NQB26/VDK-Canh-tay-robot/3D PARTS/gripper_finger_l.STL

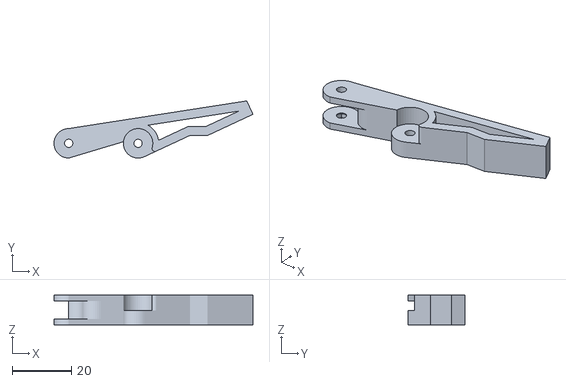
[picture p1: CAD file, 2026-10-27]
3D PARTS/gripper_finger_l.STL
67.4 x 19.4 x 10.0
