NQB26/VDK-Canh-tay-robot/3D PARTS/khop_xoay.STL

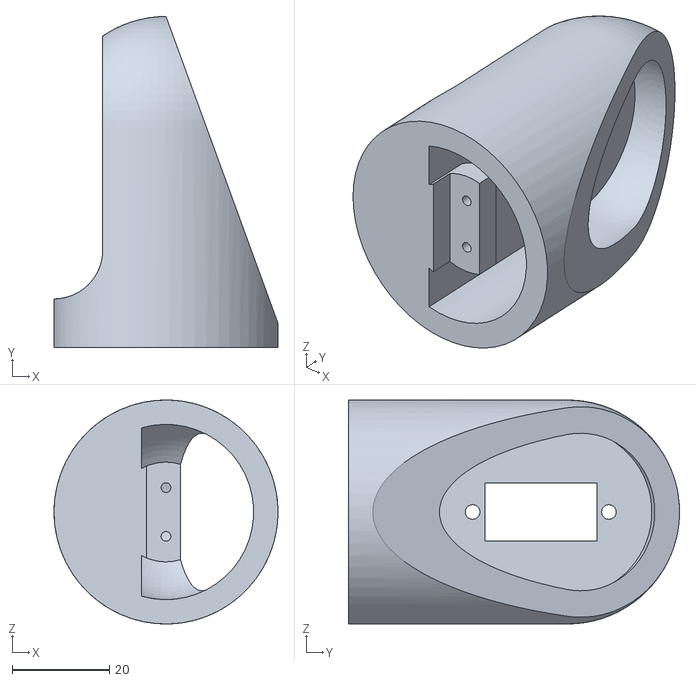
[picture p2: CAD file, 2026-10-27]
3D PARTS/khop_xoay.STL
46.0 x 68.0 x 46.0
