NQB26/VDK-Canh-tay-robot/3D PARTS/gripper_body_cover.STL

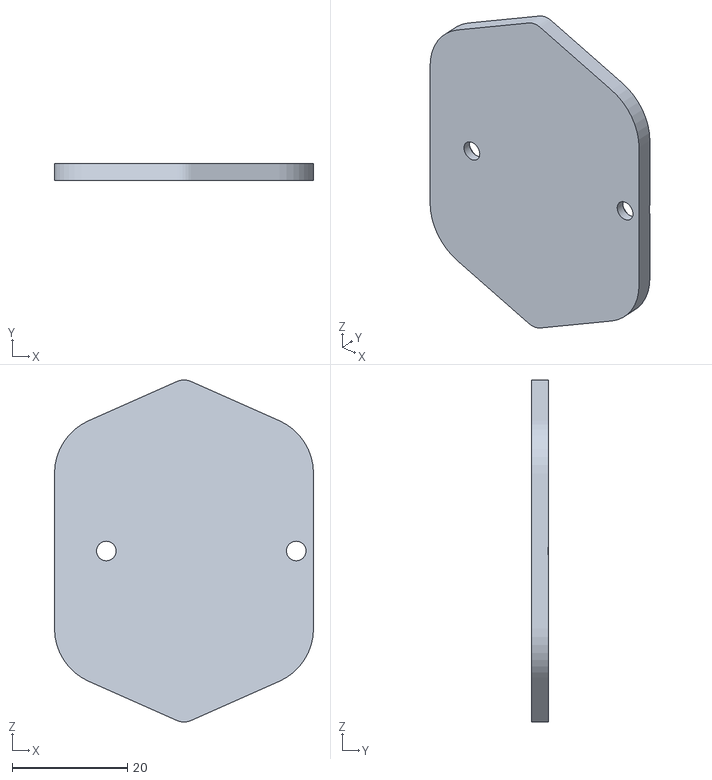
[picture p3: CAD file, 2026-10-27]
3D PARTS/gripper_body_cover.STL
45.0 x 3.00 x 59.4
