NQB26/VDK-Canh-tay-robot/3D PARTS/canh_tay_don_3.STL

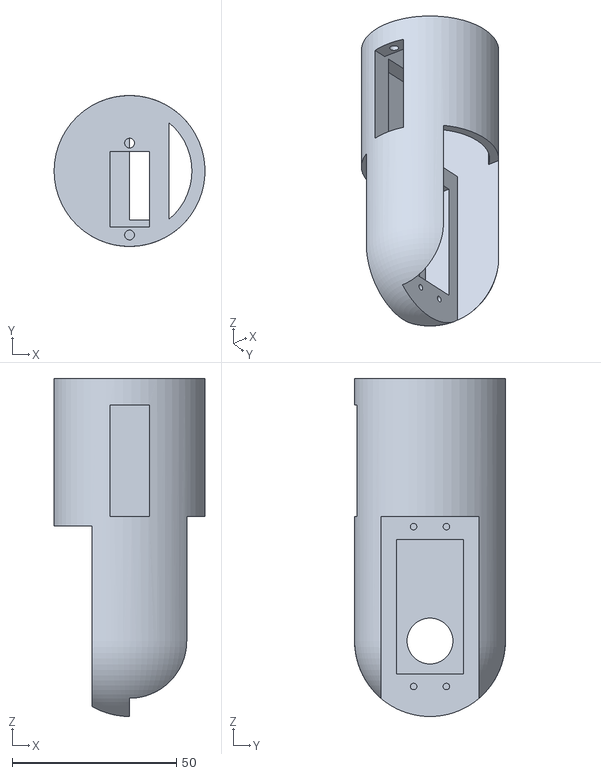
[picture p4: CAD file, 2026-10-27]
3D PARTS/canh_tay_don_3.STL
46.0 x 46.0 x 103.0
