NQB26/VDK-Canh-tay-robot/3D PARTS/gripper_link.STL

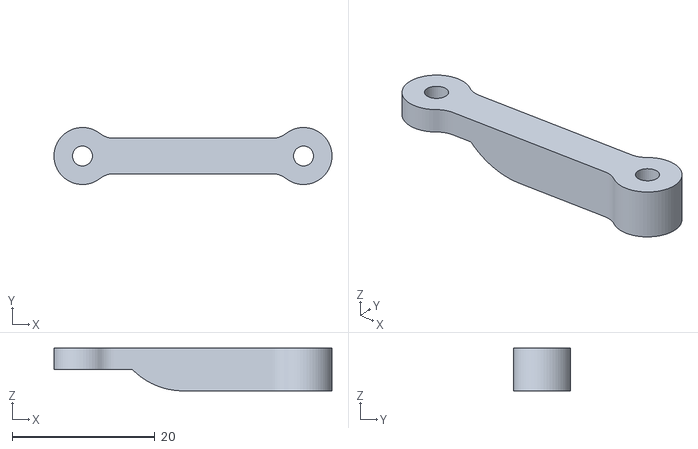
[picture p5: CAD file, 2026-10-27]
3D PARTS/gripper_link.STL
39.0 x 8.00 x 6.00
