NQB26/VDK-Canh-tay-robot/3D PARTS/de.STL

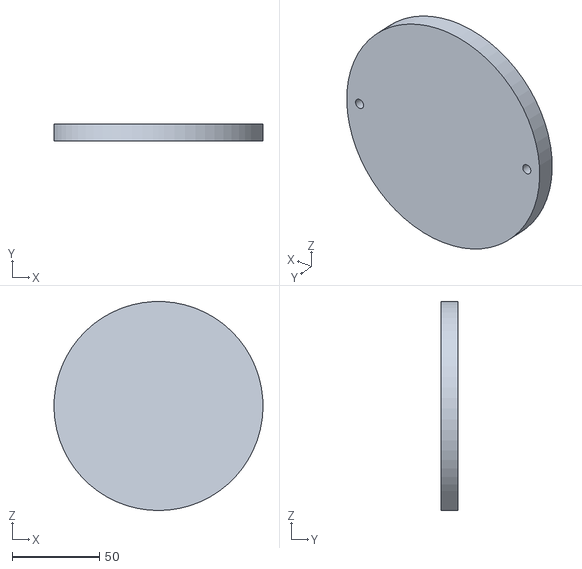
[picture p6: CAD file, 2026-10-27]
3D PARTS/de.STL
120.0 x 10.0 x 120.0
