NQB26/VDK-Canh-tay-robot/3D PARTS/canh_tay_don_1.STL

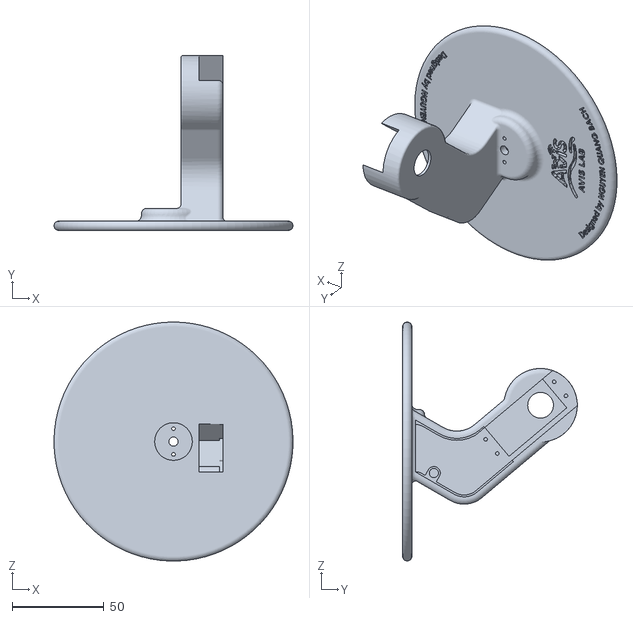
[picture p7: CAD file, 2026-10-27]
3D PARTS/canh_tay_don_1.STL
130.0 x 95.0 x 129.9
