NQB26/VDK-Canh-tay-robot/3D PARTS/gripper_gear_l.STL

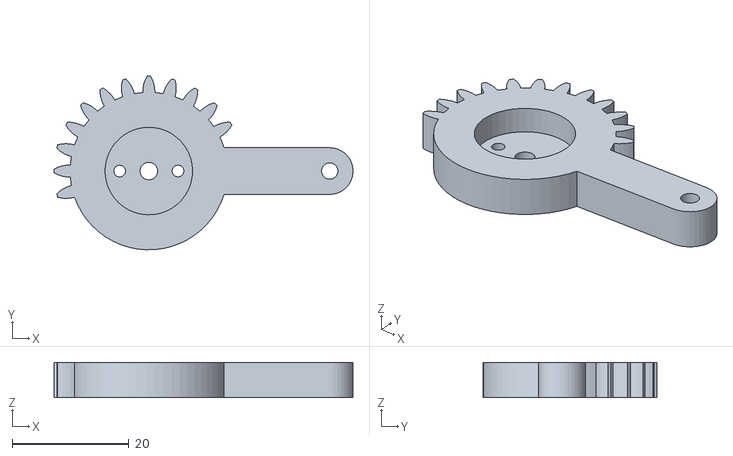
[picture p8: CAD file, 2026-10-27]
3D PARTS/gripper_gear_l.STL
51.2 x 29.7 x 6.00
