NQB26/VDK-Canh-tay-robot/3D PARTS/chan_de.STL

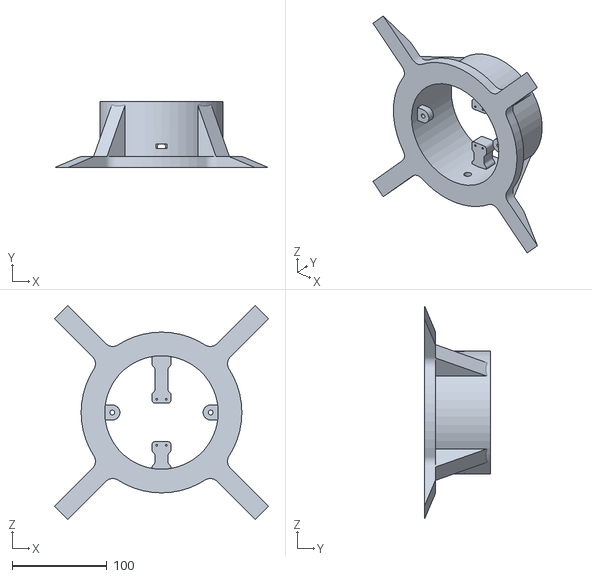
[picture p9: CAD file, 2026-10-27]
3D PARTS/chan_de.STL
226.3 x 70.0 x 226.3
