NQB26/VDK-Canh-tay-robot/3D PARTS/gripper_body.STL

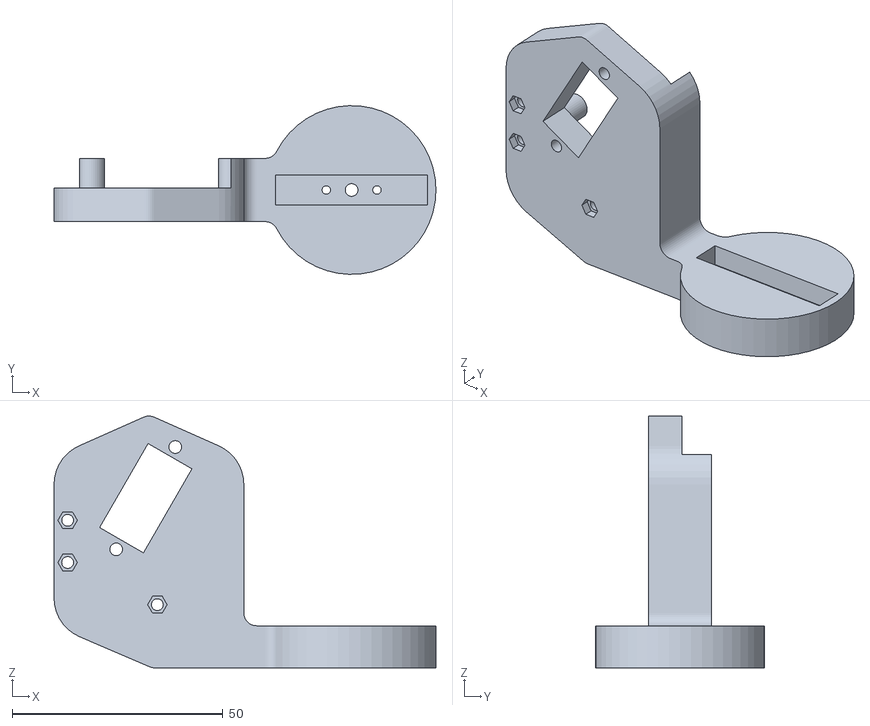
[picture p10: CAD file, 2026-10-27]
3D PARTS/gripper_body.STL
90.5 x 40.0 x 59.7
