NQB26/VDK-Canh-tay-robot/3D PARTS/canh_tay_don_2.STL

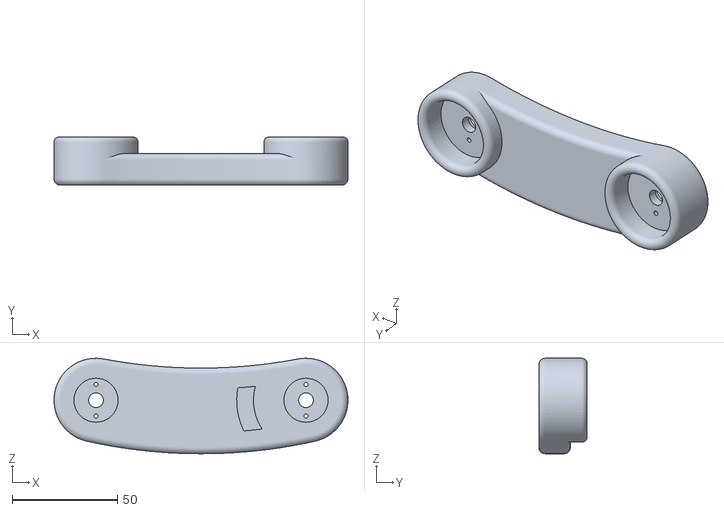
[picture p11: CAD file, 2026-10-27]
3D PARTS/canh_tay_don_2.STL
140.0 x 23.0 x 45.5
