NQB26/VDK-Canh-tay-robot/3D PARTS/test.STL

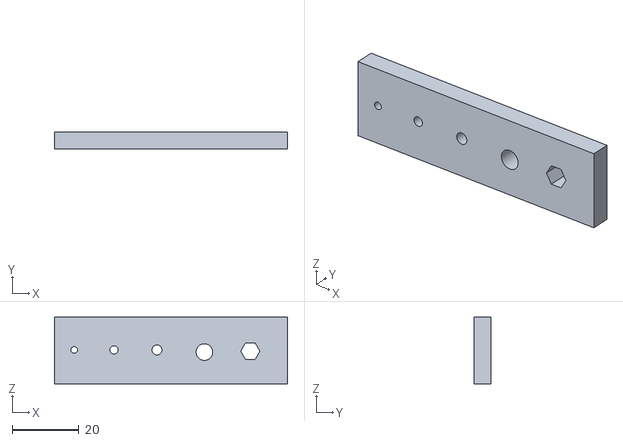
[picture p12: CAD file, 2026-10-27]
3D PARTS/test.STL
70.0 x 5.00 x 20.0
