NQB26/VDK-Canh-tay-robot/3D PARTS/nap_1.STL

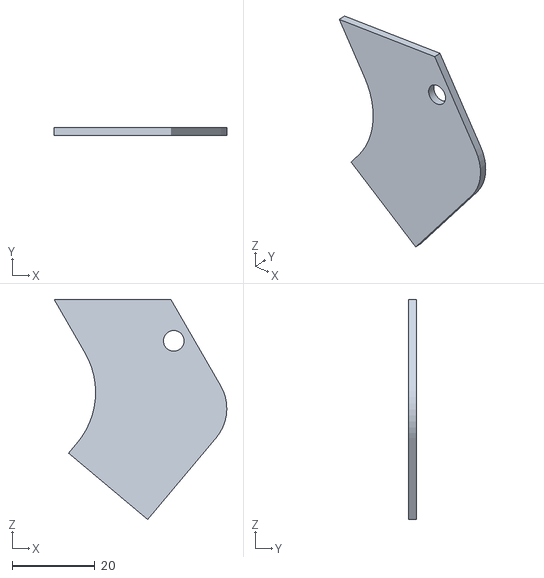
[picture p13: CAD file, 2026-10-27]
3D PARTS/nap_1.STL
41.8 x 2.00 x 53.3
