NQB26/VDK-Canh-tay-robot/3D PARTS/gripper_gear_r.STL

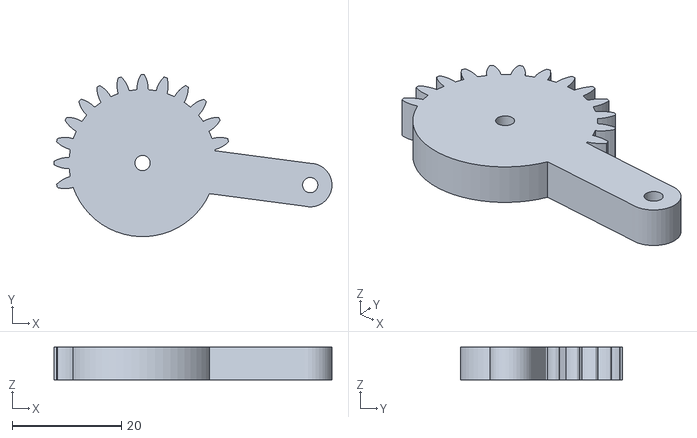
[picture p14: CAD file, 2026-10-27]
3D PARTS/gripper_gear_r.STL
51.0 x 29.7 x 6.00
