NQB26/VDK-Canh-tay-robot/(list of files, cad)

Other CAD files:
3D PARTS/gripper_finger_r.STL
