NQB26/VDK-Canh-tay-robot/RobotArm_6DOF/RobotArm_6DOF.ioc

Mcu.UserName=STM32F411CEUx
PA10.GPIO_Label=BLE_RX
PA10.Signal=USART1_RX
PA13.Signal=SYS_JTMS-SWDIO
PA14.Signal=SYS_JTCK-SWCLK
PA2.GPIO_Label=LAPTOP_TX
PA2.Signal=USART2_TX
PA3.GPIO_Label=LAPTOP_RX
PA3.Signal=USART2_RX
PA6.GPIO_Label=SERVO_1
PA6.Signal=S_TIM3_CH1
PA7.GPIO_Label=SERVO_2
PA7.Signal=S_TIM3_CH2
PA9.GPIO_Label=BLE_TX
PA9.Signal=USART1_TX
PB0.GPIO_Label=SERVO_3
PB0.Signal=S_TIM3_CH3
PB1.GPIO_Label=SERVO_4
PB1.Signal=S_TIM3_CH4
PB6.GPIO_Label=SERVO_5
PB6.Signal=S_TIM4_CH1
PB7.GPIO_Label=SERVO_6
PB7.Signal=S_TIM4_CH2
