NQB26/VDK-Canh-tay-robot/RobotArm_6DOF/Core/Inc/main.h

#define LAPTOP_TX_Pin GPIO_PIN_2
#define LAPTOP_TX_GPIO_Port GPIOA
#define LAPTOP_RX_Pin GPIO_PIN_3
#define LAPTOP_RX_GPIO_Port GPIOA
#define SERVO_1_Pin GPIO_PIN_6
#define SERVO_1_GPIO_Port GPIOA
#define SERVO_2_Pin GPIO_PIN_7
#define SERVO_2_GPIO_Port GPIOA
#define SERVO_3_Pin GPIO_PIN_0
#define SERVO_3_GPIO_Port GPIOB
#define SERVO_4_Pin GPIO_PIN_1
#define SERVO_4_GPIO_Port GPIOB
#define BLE_TX_Pin GPIO_PIN_9
#define BLE_TX_GPIO_Port GPIOA
#define BLE_RX_Pin GPIO_PIN_10
#define BLE_RX_GPIO_Port GPIOA
#define SERVO_5_Pin GPIO_PIN_6
#define SERVO_5_GPIO_Port GPIOB
#define SERVO_6_Pin GPIO_PIN_7
#define SERVO_6_GPIO_Port GPIOB
