NQB26/VDK-Canh-tay-robot/(commit log)

2026-10-27 Create STM32F4 Project
    Create Keil C Project for STM32F411CEU6
2026-10-27 Update
    STM32F103C8T6 running ROS2 controller through USB-UART
2026-10-27 upload 3d files
    [canh_tay_don_1.STL, canh_tay_don_2.STL, canh_tay_don_3.STL, chan_de.STL, de.STL, gripper_body.STL, gripper_body_cover.STL, gripper_finger_l.STL]
2026-10-30 update 30/10
    Build xong phần cứng, code để test ble, test các khớp
