NQB26/VDK-Canh-tay-robot/(notices)

Notices in the files:
RobotArm_6DOF/Core/Src/main.c:
Copyright (c) 2026 STMicroelectronics.
All rights reserved.
This software is licensed under terms that can be found in the LICENSE file
